bneedhamia/CurieBLEBowlScale/README.md

# CurieBLEBowlScale
Obsolete; Intel has discontinued the Curie.

This project is an Arduino 101 (Curie) Dog water or food bowl continuous weight scale that sends results via BLE (Bluetooth Low Energy).  The measured weight can be read by any standard BLE (Bluetooth Low Energy) application. The project contains a Raspberry Pi app to upload to data.sparkfun.com.  With this data you can find when and how much your pet drinks or eats, and when you fill the bowl.

NOTE: Intel discontinued the Arduino 101 in 2017. Because of the end-of-life of the Arduino 101, this project is obsolete.

See https://github.com/bneedhamia/CurieBLEWeightMonitor scalegateway folder for instructions on setting up the Pi.

The blog about this project begins at https://needhamia.com/?p=880

This project is a follow-on to the Dog Bed Scale, [CurieBLEWeightMonitor](https://github.com/bneedhamia/CurieBLEWeightMonitor). 

## Files
* BillOfMaterials.ods = parts list, with prices and sources
* CurieBLEBowlScale.ino = the scale Aruduino 101 Sketch
* MechanicalNotes.odp = mechanical sketches showing the assembly of the scale
* ProjectDiary.odt = the day-to-day unfolding of the project over time
