bneedhamia/CurieBLEBowlScale/MechanicalNotes.odp

## Mechanical notes For the Dog Bowl Scale

Not to scale

## Side view

Counterbored

holes

Nut

12.7mm

Water

Curtain

To

Keep

Water

out

M5 bolt

Sensor load end

10mm

Min 32mm

Load Cell

12.7mm

Center access hole,

enabling assembly or

removal of the top.

Threaded

spacer

M4 bolt

10mm

12.7mm

Assembly order: 1) thread bolts into load cell 2) thread spacers onto bolts 3) thread nut onto bolt. Thread the bottom nuts before the top nuts.

The load end bolts are in the center so they are roughly under the center of gravity of the water or food bowl. Be sure the Load Cell end with the smaller holes (the M4 end) has its arrow label pointing down.

Nut

## Top View

Nut

Counterbore hole

## Bottom View

Nuts that fasten

the top onto

the Load Cell

Flathead bolts

that screw into

the Load Cell

Access hole

Routed out path

for the USB cable

Note: bolt holes and counterbore holes for the other parts are not shown.

## Top view of bottom parts – rough layout

Load Cell Amp

Load cell

Arduino

Note: the Arduino is as far left as possible, so that we can bend the USB cord

or power cord into a slot in the bottom. This slot is so that the cord goes outside

without dragging spilled water into the bottom parts.
