bneedhamia/CurieBLEBowlScale/BillOfMaterials.ods

Bill Of Materials for Arduino-Controlled Dog water or food bowl weight scale
Count | Name | Supplier | Part Number | Cost each | Total | Url | Notes
1 | Arduino/Genuino 101 | Sparkfun | DEV-13787 | $30.00 | $30.00 | https://www.sparkfun.com/products/13787 | The Sketch uses the Curie-specific BLE functions.
1 | Wall Adapter Power Supply - 9VDC 650mA | Sparkfun | TOL-00298 | $5.95 | $5.95 | https://www.sparkfun.com/products/298 | Or you could use a USB charger capable of at least 650mA. A USB charger would let you debug the scale without having to take the scale top off.
1 | Load Cell - 10kg, Straight Bar (TAL220) | Sparkfun | SEN-13329 | $6.95 | $6.95 | https://www.sparkfun.com/products/13329
1 | SparkFun Load Cell Amplifier - HX711 | Sparkfun | SEN-13230 ROHS | $9.95 | $9.95 | https://www.sparkfun.com/products/13230 | Amplifies the Load Cell signal for the Arduino
1 | 1/2 in. x 2 ft. x 4ft. Medium Density Fiberboard | Home Depot | 1508108 | $9.95 | $9.95 | http://www.homedepot.com/p/1-2-in-x-2-ft-x-4ft-Medium-Density-Fiberboard-1508108/202089097 | Top, sides, and bottom of the scale
1 | Type 316 Stainless Steel Hex Nut M4x0.7 Thread Size, 7mm Wide, 3.2mm High, pack of 50 | McMaster-Carr | 94150A335 | $3.42 | $3.42 | http://www.mcmaster.com/#94150a335 | Need only 2, but it’s handy to have them on hand.
1 | Type 316 Stainless Steel Hex Nut M5x0.8 Thread Size, 8mm Wide, 4mm High, pack of 50 | McMaster-Carr | 94150A340 | $4.12 | $4.12 | http://www.mcmaster.com/#94150a340 | Need only 2.
3 | 18-8 Stainless Steel Female Threaded Hex Standoff 10 mm Hex Size, 10 mm Length, M4 Thread Size | McMaster-Carr | 94868A625 | $1.63 | $4.89 | http://www.mcmaster.com/#94868a625 | Need 2, but it’s good to have 1 spare
3 | 18-8 Stainless Steel Female Threaded Hex Standoff 10 mm Hex Size, 10 mm Length, M5 Thread Size | McMaster-Carr | 94868A626 | $1.63 | $4.89 | http://www.mcmaster.com/#94868a626 | Need 2, but it’s good to have 1 spare
1 | Metric 18-8 Stainless Steel Flat Head Phillips Machine Screw M4 Size, 35mm Length, .7mm Pitch, pack of 50 | McMaster-Carr | 92010A240 | $7.19 | $7.19 | http://www.mcmaster.com/#92010a240 | Need 2, but they’re handy.
1 | Metric 18-8 Stainless Steel Flat Head Phillips Machine Screw, pack of 50 M5 Size, 35mm Length, .8mm Pitch | McMaster-Carr | 92010A340 | $10.86 | $10.86 | http://www.mcmaster.com/#92010a340 | Need 2, but they’re handy.
1 | Screw - Phillips Head (1/2", 4-40, 10 pack) | Sparkfun | PRT-10452 | $1.50 | $1.50 | https://www.sparkfun.com/products/10452 | Need 7, to fasten down Arduino and Load Cell Amp
1 | Nut - Metal (4-40, 10 pack) | Sparkfun | PRT-10454 | $1.50 | $1.50 | https://www.sparkfun.com/products/10454 | Need 7, to fasten down Arduino and Load Cell Amp
1 | Silicone Bumpers - Large (10x16.5mm, 4 pack) | Sparkfun | COM-10594 | $0.95 | $0.95 | https://www.sparkfun.com/products/10594 | Feet to keep the scale bottom plate from standing in water. Could probably have used the smaller feet instead: Silicone Bumpers - Small, Clear (8x2mm, 5 pack) https://www.sparkfun.com/products/10230
1 | Zak! Designs Placemat with Despicable Me 2 Minions Graphics, BPA-Free Plastic | Amazon | B00S4NHMM4 | $1.99 | $1.99 | https://www.amazon.com/Zak-Designs-Placemat-Despicable-Graphics/dp/B00S4NHMM4 | Cut this down to the size of the top of the scale, to keep water off of the top of the scale. Of course, you can instead get a Frozen-themed one.
 | miscellaneous hookup wire (22 AWG, stranded) | Sparkfun |  |  | $0.00 |  | Use Stranded wire for the wires connecting boards. Stranded wire will flex; solid wire will quickly break when repeatedly flexed.
10 | Molex 4 position, 0.100” spacing, single row, Connector Housing | Digikey | 50-57-9004-P | $0.43 | $4.29 | http://www.digikey.com/product-search/en?keywords=50-57-9004-P | You need only 2 but it’s handy to have a lot on hand. I used one 4-position and 1 5-position connector, to match the 4 and 5 pin connectors on the Load Cell Amplifier
10 | CONN HOUSING 2POS .100 SINGLE | Digikey | WM2800-ND | $0.32 | $3.15 | http://www.digikey.com/product-search/en?keywords=wm2800-nd | You need only 2 but it’s handy to have a lot on hand.
 |  |  |  |  | $0.00
20 | Molex female connecter terminals 22-24 AWG tin | Digikey | 16-02-0102-C | $0.13 | $2.53 | http://www.digikey.com/product-search/en?keywords=16-02-0102-C | You need only 12, but it’s good to have spares.
1 | Break Away Headers - Long | Sparkfun | PRT-10158 | $2.95 | $2.95 | https://www.sparkfun.com/products/10158 | For connections between the Arduino female headers and the 2-connector housings.
1 | Break Away Headers – Straight, 40 pins | Sparkfun | PRT-00116 | $1.50 | $1.50 | https://www.sparkfun.com/products/116 | You snap off the number you need for 4- or 5-pin connectors you solder onto the Load Cell Amplifier
Total |  |  |  |  | 118.528
Raspberry Pi for the BLE-to-WiFi gateway
1 | Raspberry Pi 3 | Sparkfun | DEV-13825 | $39.95 | $39.95 | https://www.sparkfun.com/products/13825 | Version 3 required, for its BLE capability. This is the gateway from the scale to the cloud.
1 | MicroSD Card with Adapter - 16GB (Class 10) | Sparkfun | COM-13833 | $8.95 | $8.95 | https://www.sparkfun.com/products/13833 | For Raspberry Pi 3.
1 | Raspberry Pi Enclosure – Clear | Sparkfun | DEV-12996 | $8.95 | $8.95 | https://www.sparkfun.com/products/12996
1 | Wall Adapter Power Supply - 5.25V DC 2.4A (USB Micro-B) | Sparkfun | TOL-13831 | $7.95 | $7.95 | https://www.sparkfun.com/products/13831 | For Raspberry Pi 3.
Total |  |  |  |  | $65.80
Grand Total |  |  |  |  | $184.33
