bneedhamia/CurieBLEBowlScale/ProjectDiary.odt

# Arduino 101 continuous Dog Bowl weight scale Project Diary

Brad Needham

Begun July 16, 2016

Project blog at TO DO

@bneedhamia on Twitter

## Summary

I want to automatically weigh our dog’s water bowl, to be able to measure a) when and how much she drinks, and b) when we refill the bowl. The weight is (will be) measured by an Arduino 101 which reads a 10kg Load Cell via a Load Cell Amplifier, then transmits the result via BLE (Bluetooth Low Energy) to a Raspberry Pi gateway, which relays the data to the cloud via WiFi.

Analysis of the raw weight data over time should show when Pippa drinks and when we refill her bowl. With a little more programming, I could add a low-water alarm based on the weight of the empty bowl – but running out of water doesn’t seem to be a problem for us.

This project is similar, technologically to my Dog Bed Weight Scale, CurieBLEWeightMonitor (https://github.com/bneedhamia/CurieBLEWeightMonitor).

## Status

I’m just beginning the notes on the project. The project lies ahead.

## July 16, 2016 – It begins

Just writing up basic notes so far.

## July 17, 2016 – Mechanical design thoughts

I sketched up the mechanical connections of the Load Cell, based on the examples in Sparkfun’s Load Cell Amplifier HX711 Breakout Hookup Guide, at https://learn.sparkfun.com/tutorials/load-cell-amplifier-hx711-breakout-hookup-guide.

I noticed two challenges: 1) how to keep dog water-bowl water out of the electronics, and 2) if I use an outside edge to keep water out, how to assemble the whole thing?

I decided to use MDF (Medium Density Fiberboard) as the main construction material, because MDF holds screws well, is nicely waterproof when properly finished/painted, and I have a lot of it left over from a failed attempt to make a CNC machine. A square box with an outside curtain should keep the water out of the electronics, and if I fasten it to the top with bolts, I should be able to assemble it after assembling the other parts.

I’m not entirely happy with the decision to fasten the MDF with bolts – that’s a very expensive way of connecting it, and takes a lot of precision. After thinking about the design a bit, I realized that I can put an access hole in the center of the bottom piece, which will let me get a nut driver to the center Load bolts, which will let me assemble or remove the top part, with the glued-on curtain, as a final assembly step.

## July 20, 2016 – Detailed mechanical design

I decided that 3/4” MDF was way too thick for the project, and decided to go with 1/2” MDF. Bought a 2’x4’ sheet of 1/2” MDF and cut out a top (7” square) and bottom (5-1/2” square). I also bored a 1-1/8” access hole in the center of the bottom piece (see the mechanical notes).

With the bottom piece cut out I roughly laid out the 3 parts of the circuit: the Load Cell, Load Cell Amplifier, and Arduino 101. I then picked a desired gap between the top and bottom MDF pieces – this gap needs to be large enough that no electrical parts from the circuit on the bottom piece touch the top piece. Using the gap, I then calculated what general height I want for the spacers that separate the Load Cell from the top and bottom MDF pieces.

With all those numbers in place, and with the datasheet of the Load Cell, I worked out the hardware needed (bolts, nuts, spacers), and looked them up on McMaster-Carr.

Once the parts arrive I can assemble the top, bottom, and Load Cell, then I can measure what height I want for the sides of this MDF box. The sides will fasten to the top to prevent spilled water from getting into the electronics.

## July 23, 2016 – Drilling mounting holes

Today I drilled and counterbored the holes for the bolts and nuts that hold the Arduino and Load Cell Amplifier in place. Because the bowl scale is small enough to fit on the drill press, the process was easy (compared to drilling the mounting holes for the Bed scale load sensors).

## July 24, 2016 – A bit of research, assembling connectors

I had assumed that there isn’t a commercial BLE dog bowl scale. Today I happened to search for “water bowl scale” and was surprised to find a related product: Eyenimal Intelligent Pet Bowl (https://www.teampetsupply.com/product/eyenimal-intelligent-pet-bowl-1-8-liters-black/). It’s a pet food bowl/scale to enable the owner to measure out the right amount of food. It’s not designed to either report the weight of the bowl or run continuously.

Today I also crimped together the connectors that connect the Load Cell to the Load Cell Amplifier and the Load Cell Amplifier to the Arduino 101. I had a lot of trouble with the Load Cell wires because they are so thin – I probably should have soldered on some thicker wire that would accept the crimp connectors better.

## July 27, 2016 – McMaster-Carr parts arrived

The final hardware (bolts, spacers, and nuts) arrived today. I enthusiastically marked out and drilled the final two holes in the bottom plate, then counterbored the first hole… and found I’d counterbored the wrong side, ruining the bottom plate. Back to Square One, I cut a new bottom plate and drilled and counterbored its holes. The only remaining woodworking to do on the bottom plate is to route out a channel in the bottom of that plate that will hold the USB or power cable without providing a channel for spilled water to get into the electronics.

Next Steps:

- Finish assembling the Load Cell and top and bottom of the scale
- Test the finished scale.
- Disassemble the scale, paint all the wooden parts to protect them from water, and reassemble the scale.

## July 27, 2016 – Finishing the woodworking

I drilled the last holes in the scale, routed a path for the USB/Power cable, glued the top parts together and painted part of the bottom part.

## July 30, 2016 – Final assembly and calibration

Over the past few days I’ve been spray painting one wooden part or another, painting the top, then the underside of the top and bottom. Today all that paint is dry and the scale is ready to assemble.

I fastened the parts using the bolts and screws, then turned on the scale with nothing sitting on top of it (just the fastened top plate), waited 20 minutes for the circuit to come to a stable temperature, and measured the Load Cell Amplifier output – that is the OFFSET calibration value. I then took a nominally 5 pound weight, measured it on a food scale and noted the weight, at 2.245 kg. I then placed the weight on the scale, waited ½ hour for the scale to stabilize, and measured the output again. Taking the difference divided by 2.245 kg gave me the SCALE; the Load Cell Amplifier units per kilogram.

I did a quick test, measuring the weight of a full water bowl on the same food scale (1.168 kg), then placed that full bowl on the calibrated dog bowl scale and read the BLE output on my phone: 1.170 kg. So the bowl scale’s reading is just 2 grams higher than the food scale – that’s close enough for me! With that accuracy, I should be able to estimate how much water Pippa drinks from the bowl, and I might even be able to notice evaporation.

## July 31, 2016 – uploading to Sparkfun; testing calibration

I modified the CurieBLEWeightMonitor scalegateway.js to read only one value rather than 5 users’ weights.

I tested the scale with various amounts of water, looking at the values uploaded to Sparkfun:

What’s on the scale | Weight read (kg)
Empty Bowl | 0.64
Nothing | 0.01
¾ liter (about the maximum for the bowl) | 1.4
½ liter | 1.155
¼ liter | 0.895

So:

- “Zero” is 10 grams off – not bad after a day of use
- ¾ liter weighs about 1.4 – 0.64 = 0.76 kg
- ½ liter weighs about 1.155 – 0.64 = 0.515 kg
- 1/3 liter weighs about 0.895 – 0.64 = 0.255 kg

The three tap water measurements suggest 1 liter of water weighs about 1.013, 1.03, and 1.02 kg vs. the standard mass of 1kg/liter. Considering the error in my measuring the water, the impurities of the water (iron, etc. from the well), the errors in calibration, and the Load Cell spec of ~3% error, a maximum error of +30 grams isn’t bad.

This accuracy is high enough that I should be able to estimate how much water Pippa drinks while downstairs (she has a second water bowl upstairs).

Next Steps:

- see what the data tells about when we fill the water bowl and when & how much Pippa drinks.
