bneedhamia/CurieBLEBowlScale/(threads)

Thread 1 (2017-07-03):

Stops uploading after a day or so

bneedhamia, 2017-07-03:
There is some sort of bug in the Node.js code that causes the code to get into a state where it thinks it's still uploading, so it doesn't try to upload again. The symptom is that the timer goes off, then the code reads the scale, then when it gets to the upload part, it skips the upload because it thinks an old upload is still in progress.

Thread 2 (2017-10-02):

check for time passage doesn't handle rollover properly

bneedhamia, 2017-10-02:
The line
    if (now - previousWeightTimeMs > MS_PER_WEIGHT_READING) {
should instead read
    if ((long) now - previousWeightTimeMs) > MS_PER_WEIGHT_READING) {
to match the pattern described in https://playground.arduino.cc/Code/TimingRollover

It's possible this bug is causing some of the symptoms of Issue #1, because that symptom appears after millis() may have rolled over.
