bneedhamia/CurieBLEBowlScale/(commit log)

2016-07-17 initial project diary, Arduino 101 Sketch, and Materials list
    [BillOfMaterials.ods]
2016-07-21 initial mechanical design and parts list. Ready to order parts from McMaster-Carr
    [BillOfMaterials.ods]
2016-07-23 added Arduino / Load Cell Amp bolts and nuts to Bill Of Materials
    [BillOfMaterials.ods]
2016-07-25 made another pass at the Arduino Sketch
2016-07-25 Arduino sketch compiles and is ready to test with hardware
2016-07-25 quick test - seems to work so far; awaiting parts for final assembly.
2016-07-27 measure twice; cut once. Miscut the bottom plate. Made a new bottom plate
2016-07-31 Arduino sketch is working fine. Next step: write Raspberry Pi gateway code.
2016-07-31 Started editing scalegateway.js - doesn't run yet
    [scalegateway.cfg]
2016-07-31 Raspberry Pi code seems to be running. Ready for further tests
2016-07-31 fixed typo in folder name; updated a few notes
    [BillOfMaterials.ods, scalegateway.cfg]
2016-08-03 Updated the Bill of Materials with the complete list of parts
    [BillOfMaterials.ods]
2019-12-02 Arduino 101 has been discontinued
